esgange/Arduino_Milk_Syrup_Dispenser/24x motor costom dispenser.PNG

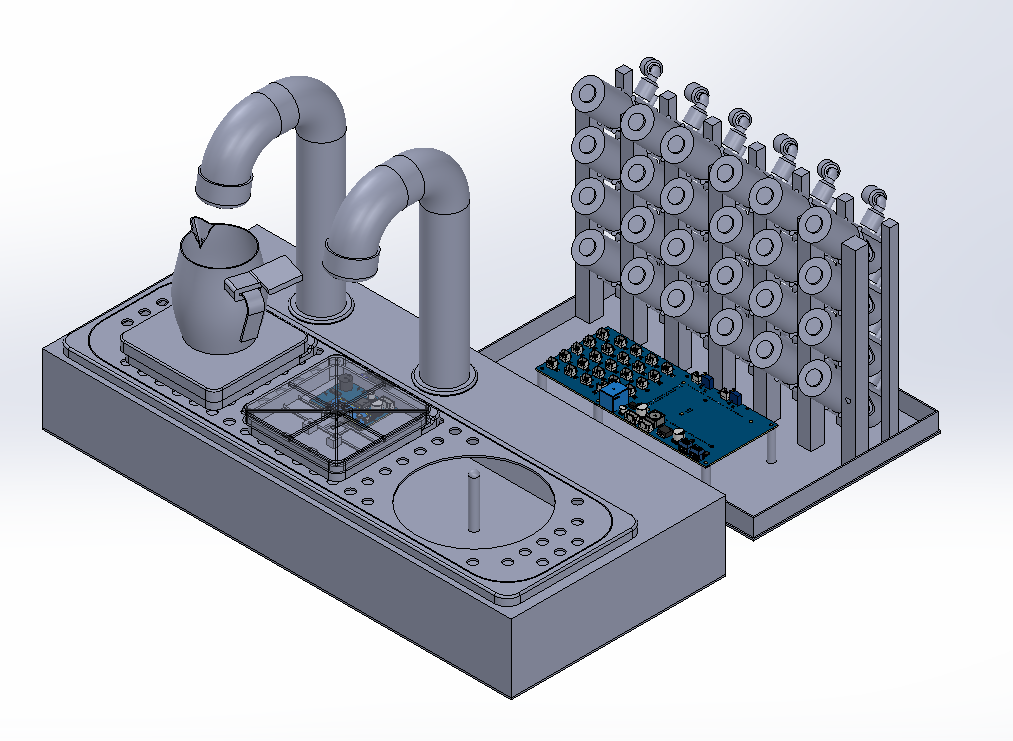
24x motor costom dispenser.PNG
