esgange/Arduino_Milk_Syrup_Dispenser/(list of files, drawings)

Other design files:
EasyEDA PCB/Dispenser Motor Controller.eprj
EasyEDA PCB/Dispenser Scale Feedback.eprj
EasyEDA PCB/Steam Wand Attachment Controller.eprj
