esgange/Arduino_Milk_Syrup_Dispenser/(commit log)

2025-10-09 new code
    insert current progress
2025-10-11 add PCB design
    minor logic and comment standard change
    [Dispenser Motor Controller.eprj, Dispenser Scale Feedback.eprj]
2025-10-21 bug fix
    bug fix on modbus comms
    [dispenser_master_modbusRTU_slave.ino, dispenser_slave_scale_feedback.ino, rtu_master_tcp_slave_translator.ino, steam_wand_modbusRTU_slave.ino]
2025-10-22 pcb update
    upload pcb design
    [Dispenser Motor Controller.eprj, Dispenser Scale Feedback.eprj, Steam Wand Attachment Controller.eprj]
2025-12-23 major update
    comms bug fix,
    [Dispenser Motor Controller.eprj, Dispenser Scale Feedback.eprj, Steam Wand Attachment Controller.eprj]
